analogicus/lelo_gr04_sky130a/rtl/README.md

The `osc_measure.pnl.v` file is automatically generated by the step "Fill Insertion" of LibreLane. It is the final post-synthesis netlist will all components added, as well as the power ports (`VPWR` and `VGND`). 

If you change the design, remember to also replace this file for LVS. Also, you can replace the `sta_post_pnr.html` and `lvs.netgen.rpt` reports from their respective steps. `sta_post_pnr.html` is captured and printed to html manually in the IPython notebook.
