analogicus/lelo_gr04_sky130a/sim/LELO_GR04/README.md

TB_NCM

#### Transient analysis (tran)

Check transient operation

|**Name**|**Parameter**|**Description**| |**Min**|**Typ**|**Max**| Unit|
|:---|:---|:---|---:|:---:|:---:|:---:| ---:|
|**Active current**|**idd\_-45** || **Spec**  | **10.000** | **40.000** | **70.000** | **uA** |
| | | |<a href='results/tran_Sch_typical.html'>Sch_typ</a>| | 14.550 |  | |
| | | |<a href='results/tran_Sch_etc_notemp.html'>Sch_etc_notemp</a>|<span style='color:red'>**9.061**</span> | 14.447 | 19.170 | |
| | | |<a href='results/tran_Sch_mc.html'>Sch_3std</a>|<span style='color:red'>**8.358**</span> | 14.952 | 21.546 | |
| | | |<a href='results/tran_Lay_typical.html'>Lay_typ</a>| | 14.579 |  | |
| | | |<a href='results/tran_Lay_etc_notemp.html'>Lay_etc_notemp</a>|<span style='color:red'>**8.260**</span> | 14.487 | 19.554 | |
| | | |<a href='results/tran_Lay_mc.html'>Lay_3std</a>|<span style='color:red'>**6.921**</span> | 14.355 | 21.789 | |
|**Active current**|**idd\_25** || **Spec**  | **10.000** | **40.000** | **70.000** | **uA** |
| | | |<a href='results/tran_Sch_typical.html'>Sch_typ</a>| | 23.083 |  | |
| | | |<a href='results/tran_Sch_etc_notemp.html'>Sch_etc_notemp</a>|17.652 | 23.163 | 30.716 | |
| | | |<a href='results/tran_Sch_mc.html'>Sch_3std</a>|17.553 | 23.322 | 29.092 | |
| | | |<a href='results/tran_Lay_typical.html'>Lay_typ</a>| | 23.460 |  | |
| | | |<a href='results/tran_Lay_etc_notemp.html'>Lay_etc_notemp</a>|17.834 | 23.538 | 31.436 | |
| | | |<a href='results/tran_Lay_mc.html'>Lay_3std</a>|16.698 | 23.255 | 29.812 | |
|**Active current**|**idd\_125** || **Spec**  | **10.000** | **40.000** | **70.000** | **uA** |
| | | |<a href='results/tran_Sch_typical.html'>Sch_typ</a>| | 36.946 |  | |
| | | |<a href='results/tran_Sch_etc_notemp.html'>Sch_etc_notemp</a>|29.076 | 37.016 | 47.541 | |
| | | |<a href='results/tran_Sch_mc.html'>Sch_3std</a>|31.487 | 37.137 | 42.787 | |
| | | |<a href='results/tran_Lay_typical.html'>Lay_typ</a>| | 37.853 |  | |
| | | |<a href='results/tran_Lay_etc_notemp.html'>Lay_etc_notemp</a>|29.602 | 37.909 | 49.014 | |
| | | |<a href='results/tran_Lay_mc.html'>Lay_3std</a>|31.108 | 37.686 | 44.264 | |
|**Leakage current**|**iddq\_-45** || **Spec**  | **0.000** | **50.000** | **100.000** | **nA** |
| | | |<a href='results/tran_Sch_typical.html'>Sch_typ</a>| | 1.314 |  | |
| | | |<a href='results/tran_Sch_etc_notemp.html'>Sch_etc_notemp</a>|0.855 | 1.150 | 1.456 | |
| | | |<a href='results/tran_Sch_mc.html'>Sch_3std</a>|0.800 | 1.197 | 1.594 | |
| | | |<a href='results/tran_Lay_typical.html'>Lay_typ</a>| | 1.743 |  | |
| | | |<a href='results/tran_Lay_etc_notemp.html'>Lay_etc_notemp</a>|1.859 | 2.622 | 2.808 | |
| | | |<a href='results/tran_Lay_mc.html'>Lay_3std</a>|1.464 | 2.490 | 3.516 | |
|**Leakage current**|**iddq\_25** || **Spec**  | **0.000** | **50.000** | **100.000** | **nA** |
| | | |<a href='results/tran_Sch_typical.html'>Sch_typ</a>| | 1.913 |  | |
| | | |<a href='results/tran_Sch_etc_notemp.html'>Sch_etc_notemp</a>|1.256 | 1.921 | 8.685 | |
| | | |<a href='results/tran_Sch_mc.html'>Sch_3std</a>|1.454 | 1.881 | 2.308 | |
| | | |<a href='results/tran_Lay_typical.html'>Lay_typ</a>| | 3.424 |  | |
| | | |<a href='results/tran_Lay_etc_notemp.html'>Lay_etc_notemp</a>|2.720 | 3.402 | 11.257 | |
| | | |<a href='results/tran_Lay_mc.html'>Lay_3std</a>|2.577 | 3.297 | 4.017 | |
|**Leakage current**|**iddq\_125** || **Spec**  | **0.000** | **50.000** | **100.000** | **nA** |
| | | |<a href='results/tran_Sch_typical.html'>Sch_typ</a>| | 10.349 |  | |
| | | |<a href='results/tran_Sch_etc_notemp.html'>Sch_etc_notemp</a>|9.787 | 15.645 | 39.508 | |
| | | |<a href='results/tran_Sch_mc.html'>Sch_3std</a>|10.124 | 10.457 | 10.790 | |
| | | |<a href='results/tran_Lay_typical.html'>Lay_typ</a>| | 15.454 |  | |
| | | |<a href='results/tran_Lay_etc_notemp.html'>Lay_etc_notemp</a>|12.109 | 20.570 | 44.940 | |
| | | |<a href='results/tran_Lay_mc.html'>Lay_3std</a>|14.511 | 15.328 | 16.145 | |
|**Oscillation frequency @ -45C**|**fosc\_-45** || **Spec**  | **1.406** | **1.875** | **2.344** | **MHz** |
| | | |<a href='results/tran_Sch_typical.html'>Sch_typ</a>| | 1.813 |  | |
| | | |<a href='results/tran_Sch_etc_notemp.html'>Sch_etc_notemp</a>|<span style='color:red'>**1.106**</span> | 1.797 | <span style='color:orange'>**2.448**</span> | |
| | | |<a href='results/tran_Sch_mc.html'>Sch_3std</a>|<span style='color:red'>**0.915**</span> | 1.844 | <span style='color:red'>**2.774**</span> | |
| | | |<a href='results/tran_Lay_typical.html'>Lay_typ</a>| | 1.470 |  | |
| | | |<a href='results/tran_Lay_etc_notemp.html'>Lay_etc_notemp</a>|<span style='color:red'>**0.850**</span> | 1.449 | 1.943 | |
| | | |<a href='results/tran_Lay_mc.html'>Lay_3std</a>|<span style='color:red'>**0.702**</span> | 1.440 | 2.179 | |
|**Oscillation frequency @ 25C**|**fosc\_25** || **Spec**  | **2.081** | **2.775** | **3.469** | **MHz** |
| | | |<a href='results/tran_Sch_typical.html'>Sch_typ</a>| | 2.696 |  | |
| | | |<a href='results/tran_Sch_etc_notemp.html'>Sch_etc_notemp</a>|<span style='color:orange'>**2.064**</span> | 2.699 | <span style='color:orange'>**3.644**</span> | |
| | | |<a href='results/tran_Sch_mc.html'>Sch_3std</a>|<span style='color:red'>**1.773**</span> | 2.711 | <span style='color:orange'>**3.650**</span> | |
| | | |<a href='results/tran_Lay_typical.html'>Lay_typ</a>| | 2.168 |  | |
| | | |<a href='results/tran_Lay_etc_notemp.html'>Lay_etc_notemp</a>|<span style='color:red'>**1.690**</span> | 2.170 | 2.852 | |
| | | |<a href='results/tran_Lay_mc.html'>Lay_3std</a>|<span style='color:red'>**1.427**</span> | 2.139 | 2.852 | |
|**Oscillation frequency @ 125C**|**fosc\_125** || **Spec**  | **3.598** | **4.797** | **5.996** | **MHz** |
| | | |<a href='results/tran_Sch_typical.html'>Sch_typ</a>| | 4.522 |  | |
| | | |<a href='results/tran_Sch_etc_notemp.html'>Sch_etc_notemp</a>|<span style='color:orange'>**3.470**</span> | 4.562 | <span style='color:orange'>**6.186**</span> | |
| | | |<a href='results/tran_Sch_mc.html'>Sch_3std</a>|<span style='color:red'>**3.392**</span> | 4.527 | 5.663 | |
| | | |<a href='results/tran_Lay_typical.html'>Lay_typ</a>| | <span style='color:orange'>**3.550**</span> |  | |
| | | |<a href='results/tran_Lay_etc_notemp.html'>Lay_etc_notemp</a>|<span style='color:red'>**2.788**</span> | <span style='color:orange'>**3.552**</span> | 4.648 | |
| | | |<a href='results/tran_Lay_mc.html'>Lay_3std</a>|<span style='color:red'>**2.616**</span> | <span style='color:orange'>**3.517**</span> | 4.418 | |
|**Temperature error (calibrated @ 25C)**|**t\_err\_max** || **Spec**  | **-10.00** | **0.00** | **10.00** | **C** |
| | | |<a href='results/tran_Sch_typical.html'>Sch_typ</a>| | 0.14 |  | |
| | | |<a href='results/tran_Sch_etc_notemp.html'>Sch_etc_notemp</a>|-1.83 | 0.08 | 3.61 | |
| | | |<a href='results/tran_Sch_mc.html'>Sch_3std</a>|<span style='color:red'>**-10.33**</span> | 5.08 | <span style='color:red'>**20.50**</span> | |
| | | |<a href='results/tran_Lay_typical.html'>Lay_typ</a>| | 0.17 |  | |
| | | |<a href='results/tran_Lay_etc_notemp.html'>Lay_etc_notemp</a>|-1.84 | 0.03 | 2.08 | |
| | | |<a href='results/tran_Lay_mc.html'>Lay_3std</a>|-9.18 | 3.39 | <span style='color:red'>**15.96**</span> | |
|**Temperature error (calibrated @ 25C)**|**t\_err\_min** || **Spec**  | **-10.00** | **0.00** | **10.00** | **C** |
| | | |<a href='results/tran_Sch_typical.html'>Sch_typ</a>| | -4.17 |  | |
| | | |<a href='results/tran_Sch_etc_notemp.html'>Sch_etc_notemp</a>|<span style='color:red'>**-62.49**</span> | -5.59 | -2.15 | |
| | | |<a href='results/tran_Sch_mc.html'>Sch_3std</a>|<span style='color:red'>**-24.64**</span> | <span style='color:red'>**-10.04**</span> | 4.57 | |
| | | |<a href='results/tran_Lay_typical.html'>Lay_typ</a>| | -6.51 |  | |
| | | |<a href='results/tran_Lay_etc_notemp.html'>Lay_etc_notemp</a>|<span style='color:red'>**-98.17**</span> | -8.15 | -4.02 | |
| | | |<a href='results/tran_Lay_mc.html'>Lay_3std</a>|<span style='color:red'>**-42.23**</span> | <span style='color:red'>**-13.59**</span> | <span style='color:red'>**15.05**</span> | |
|**Temperature error 0-70C (calibrated @ 25C)**|**t\_err\_com\_max** || **Spec**  | **-10.00** | **0.00** | **10.00** | **C** |
| | | |<a href='results/tran_Sch_typical.html'>Sch_typ</a>| | 0.14 |  | |
| | | |<a href='results/tran_Sch_etc_notemp.html'>Sch_etc_notemp</a>|-1.83 | 0.08 | 1.90 | |
| | | |<a href='results/tran_Sch_mc.html'>Sch_3std</a>|-3.51 | 2.08 | 7.67 | |
| | | |<a href='results/tran_Lay_typical.html'>Lay_typ</a>| | 0.17 |  | |
| | | |<a href='results/tran_Lay_etc_notemp.html'>Lay_etc_notemp</a>|-1.84 | 0.03 | 2.08 | |
| | | |<a href='results/tran_Lay_mc.html'>Lay_3std</a>|-5.27 | 1.81 | 8.90 | |
|**Temperature error 0-70C (calibrated @ 25C)**|**t\_err\_com\_min** || **Spec**  | **-10.00** | **0.00** | **10.00** | **C** |
| | | |<a href='results/tran_Sch_typical.html'>Sch_typ</a>| | -1.06 |  | |
| | | |<a href='results/tran_Sch_etc_notemp.html'>Sch_etc_notemp</a>|-5.09 | -1.16 | 0.72 | |
| | | |<a href='results/tran_Sch_mc.html'>Sch_3std</a>|-7.90 | -3.24 | 1.41 | |
| | | |<a href='results/tran_Lay_typical.html'>Lay_typ</a>| | -1.62 |  | |
| | | |<a href='results/tran_Lay_etc_notemp.html'>Lay_etc_notemp</a>|-8.85 | -1.81 | 0.40 | |
| | | |<a href='results/tran_Lay_mc.html'>Lay_3std</a>|<span style='color:red'>**-10.68**</span> | -3.53 | 3.61 | |
