analogicus/lelo_gr04_sky130a/sim/LELO_GR04_OSC_v2/README.md

TB_NCM

This testbench is deprecated in favor of the top-level `LELO_GR04` tests.

#### Transient analysis (tran)

Check transient operation

|**Name**|**Parameter**|**Description**| |**Min**|**Typ**|**Max**| Unit|
|:---|:---|:---|---:|:---:|:---:|:---:| ---:|
|**Active current**|**idd\_-45** || **Spec**  | **10.000** | **40.000** | **70.000** | **uA** |
| | | |<a href='results/tran_Sch_typical.html'>Sch_typ</a>| | 17.126 |  | |
| | | |<a href='results/tran_Sch_etc_notemp.html'>Sch_etc_notemp</a>|<span style='color:red'>**8.287**</span> | 16.891 | 22.358 | |
| | | |<a href='results/tran_Sch_mc.html'>Sch_3std</a>|<span style='color:red'>**8.979**</span> | 17.649 | 26.319 | |
| | | |<a href='results/tran_Lay_typical.html'>Lay_typ</a>| | 16.992 |  | |
| | | |<a href='results/tran_Lay_etc_notemp.html'>Lay_etc_notemp</a>|<span style='color:red'>**7.063**</span> | 16.693 | 22.694 | |
| | | |<a href='results/tran_Lay_mc.html'>Lay_3std</a>|<span style='color:red'>**5.799**</span> | 17.211 | 28.623 | |
|**Active current**|**idd\_125** || **Spec**  | **10.000** | **40.000** | **70.000** | **uA** |
| | | |<a href='results/tran_Sch_typical.html'>Sch_typ</a>| | 43.457 |  | |
| | | |<a href='results/tran_Sch_etc_notemp.html'>Sch_etc_notemp</a>|35.249 | 43.607 | 54.875 | |
| | | |<a href='results/tran_Sch_mc.html'>Sch_3std</a>|35.648 | 43.714 | 51.780 | |
| | | |<a href='results/tran_Lay_typical.html'>Lay_typ</a>| | 44.480 |  | |
| | | |<a href='results/tran_Lay_etc_notemp.html'>Lay_etc_notemp</a>|35.903 | 44.638 | 56.470 | |
| | | |<a href='results/tran_Lay_mc.html'>Lay_3std</a>|34.119 | 44.468 | 54.818 | |
|**Leakage current**|**iddq\_-45** || **Spec**  | **0.000** | **50.000** | **100.000** | **nA** |
| | | |<a href='results/tran_Sch_typical.html'>Sch_typ</a>| | 0.920 |  | |
| | | |<a href='results/tran_Sch_etc_notemp.html'>Sch_etc_notemp</a>|0.663 | 0.784 | 0.951 | |
| | | |<a href='results/tran_Sch_mc.html'>Sch_3std</a>|0.452 | 0.823 | 1.194 | |
| | | |<a href='results/tran_Lay_typical.html'>Lay_typ</a>| | 1.276 |  | |
| | | |<a href='results/tran_Lay_etc_notemp.html'>Lay_etc_notemp</a>|0.767 | 1.558 | 1.923 | |
| | | |<a href='results/tran_Lay_mc.html'>Lay_3std</a>|0.642 | 1.564 | 2.486 | |
|**Leakage current**|**iddq\_125** || **Spec**  | **0.000** | **50.000** | **100.000** | **nA** |
| | | |<a href='results/tran_Sch_typical.html'>Sch_typ</a>| | 7.084 |  | |
| | | |<a href='results/tran_Sch_etc_notemp.html'>Sch_etc_notemp</a>|6.275 | 12.102 | 34.271 | |
| | | |<a href='results/tran_Sch_mc.html'>Sch_3std</a>|7.003 | 7.229 | 7.455 | |
| | | |<a href='results/tran_Lay_typical.html'>Lay_typ</a>| | 10.187 |  | |
| | | |<a href='results/tran_Lay_etc_notemp.html'>Lay_etc_notemp</a>|8.696 | 15.362 | 38.049 | |
| | | |<a href='results/tran_Lay_mc.html'>Lay_3std</a>|9.793 | 10.385 | 10.977 | |
|**Oscillation frequency @ -45C**|**fosc\_-45** || **Spec**  | **1.406** | **1.875** | **2.344** | **MHz** |
| | | |<a href='results/tran_Sch_typical.html'>Sch_typ</a>| | 2.265 |  | |
| | | |<a href='results/tran_Sch_etc_notemp.html'>Sch_etc_notemp</a>|<span style='color:red'>**1.114**</span> | 2.208 | <span style='color:red'>**3.063**</span> | |
| | | |<a href='results/tran_Sch_mc.html'>Sch_3std</a>|<span style='color:red'>**1.038**</span> | 2.306 | <span style='color:red'>**3.575**</span> | |
| | | |<a href='results/tran_Lay_typical.html'>Lay_typ</a>| | 1.854 |  | |
| | | |<a href='results/tran_Lay_etc_notemp.html'>Lay_etc_notemp</a>|<span style='color:red'>**0.787**</span> | 1.790 | <span style='color:orange'>**2.462**</span> | |
| | | |<a href='results/tran_Lay_mc.html'>Lay_3std</a>|<span style='color:red'>**0.681**</span> | 1.878 | <span style='color:red'>**3.075**</span> | |
|**Oscillation frequency @ 25C**|**fosc\_25** || **Spec**  | **2.081** | **2.775** | **3.469** | **MHz** |
| | | |<a href='results/tran_Sch_typical.html'>Sch_typ</a>| | <span style='color:orange'>**3.472**</span> |  | |
| | | |<a href='results/tran_Sch_etc_notemp.html'>Sch_etc_notemp</a>|2.647 | 3.463 | <span style='color:red'>**4.745**</span> | |
| | | |<a href='results/tran_Sch_mc.html'>Sch_3std</a>|2.158 | <span style='color:orange'>**3.489**</span> | <span style='color:red'>**4.819**</span> | |
| | | |<a href='results/tran_Lay_typical.html'>Lay_typ</a>| | 2.823 |  | |
| | | |<a href='results/tran_Lay_etc_notemp.html'>Lay_etc_notemp</a>|2.194 | 2.817 | <span style='color:red'>**3.760**</span> | |
| | | |<a href='results/tran_Lay_mc.html'>Lay_3std</a>|<span style='color:red'>**1.660**</span> | 2.837 | <span style='color:red'>**4.014**</span> | |
|**Oscillation frequency @ 125C**|**fosc\_125** || **Spec**  | **3.598** | **4.797** | **5.996** | **MHz** |
| | | |<a href='results/tran_Sch_typical.html'>Sch_typ</a>| | 5.951 |  | |
| | | |<a href='results/tran_Sch_etc_notemp.html'>Sch_etc_notemp</a>|4.561 | <span style='color:orange'>**6.020**</span> | <span style='color:red'>**8.180**</span> | |
| | | |<a href='results/tran_Sch_mc.html'>Sch_3std</a>|4.284 | 5.956 | <span style='color:red'>**7.628**</span> | |
| | | |<a href='results/tran_Lay_typical.html'>Lay_typ</a>| | 4.715 |  | |
| | | |<a href='results/tran_Lay_etc_notemp.html'>Lay_etc_notemp</a>|3.691 | 4.717 | <span style='color:orange'>**6.232**</span> | |
| | | |<a href='results/tran_Lay_mc.html'>Lay_3std</a>|<span style='color:red'>**3.224**</span> | 4.710 | <span style='color:orange'>**6.197**</span> | |
|**Temperature error (calibrated @ 25C)**|**t\_err\_max** || **Spec**  | **-10.00** | **0.00** | **10.00** | **C** |
| | | |<a href='results/tran_Sch_typical.html'>Sch_typ</a>| | 0.14 |  | |
| | | |<a href='results/tran_Sch_etc_notemp.html'>Sch_etc_notemp</a>|-2.63 | 1.71 | 4.82 | |
| | | |<a href='results/tran_Sch_mc.html'>Sch_3std</a>|<span style='color:red'>**-10.15**</span> | 5.10 | <span style='color:red'>**20.34**</span> | |
| | | |<a href='results/tran_Lay_typical.html'>Lay_typ</a>| | 0.27 |  | |
| | | |<a href='results/tran_Lay_etc_notemp.html'>Lay_etc_notemp</a>|-2.27 | 0.24 | 4.85 | |
| | | |<a href='results/tran_Lay_mc.html'>Lay_3std</a>|<span style='color:red'>**-12.95**</span> | 4.36 | <span style='color:red'>**21.67**</span> | |
|**Temperature error (calibrated @ 25C)**|**t\_err\_min** || **Spec**  | **-10.00** | **0.00** | **10.00** | **C** |
| | | |<a href='results/tran_Sch_typical.html'>Sch_typ</a>| | -4.52 |  | |
| | | |<a href='results/tran_Sch_etc_notemp.html'>Sch_etc_notemp</a>|<span style='color:red'>**-92.04**</span> | -7.82 | -3.33 | |
| | | |<a href='results/tran_Sch_mc.html'>Sch_3std</a>|<span style='color:red'>**-24.96**</span> | <span style='color:red'>**-10.20**</span> | 4.56 | |
| | | |<a href='results/tran_Lay_typical.html'>Lay_typ</a>| | -7.28 |  | |
| | | |<a href='results/tran_Lay_etc_notemp.html'>Lay_etc_notemp</a>|<span style='color:red'>**-125.93**</span> | <span style='color:red'>**-11.09**</span> | -5.43 | |
| | | |<a href='results/tran_Lay_mc.html'>Lay_3std</a>|<span style='color:red'>**-38.32**</span> | <span style='color:red'>**-14.81**</span> | 8.71 | |
