analogicus/lelo_gr04_sky130a/sim/LELO_GR04/results/tran_Lay_etc_notemp.md

### Summary tran_Lay_etc_notemp

For details see <a href='tran_Lay_etc_notemp.html'>tran_Lay_etc_notemp.html</a>

|**Name**|**Parameter**|**View**|**Min** | **Typ** | **Max**|
|:---|:---|:---:|:---:|:---:|:---:|
|Active current|idd\_-45 | Spec | 10.000 uA | 40.000 uA | 70.000 uA |
| | | ('Lay',)|8.260 uA | 14.487 uA | 19.554 uA |
|Active current|idd\_25 | Spec | 10.000 uA | 40.000 uA | 70.000 uA |
| | | ('Lay',)|17.834 uA | 23.538 uA | 31.436 uA |
|Active current|idd\_125 | Spec | 10.000 uA | 40.000 uA | 70.000 uA |
| | | ('Lay',)|29.602 uA | 37.909 uA | 49.014 uA |
|Leakage current|iddq\_-45 | Spec | 0.000 nA | 50.000 nA | 100.000 nA |
| | | ('Lay',)|1.859 nA | 2.622 nA | 2.808 nA |
|Leakage current|iddq\_25 | Spec | 0.000 nA | 50.000 nA | 100.000 nA |
| | | ('Lay',)|2.720 nA | 3.402 nA | 11.257 nA |
|Leakage current|iddq\_125 | Spec | 0.000 nA | 50.000 nA | 100.000 nA |
| | | ('Lay',)|12.109 nA | 20.570 nA | 44.940 nA |
|Oscillation frequency @ -45C|fosc\_-45 | Spec | 1.406 MHz | 1.875 MHz | 2.344 MHz |
| | | ('Lay',)|0.850 MHz | 1.449 MHz | 1.943 MHz |
|Oscillation frequency @ 25C|fosc\_25 | Spec | 2.081 MHz | 2.775 MHz | 3.469 MHz |
| | | ('Lay',)|1.690 MHz | 2.170 MHz | 2.852 MHz |
|Oscillation frequency @ 125C|fosc\_125 | Spec | 3.598 MHz | 4.797 MHz | 5.996 MHz |
| | | ('Lay',)|2.788 MHz | 3.552 MHz | 4.648 MHz |
|Temperature error (calibrated @ 25C)|t\_err\_max | Spec | -10.00 C |  | 10.00 C |
| | | ('Lay',)|-1.84 C | 0.03 C | 2.08 C |
|Temperature error (calibrated @ 25C)|t\_err\_min | Spec | -10.00 C |  | 10.00 C |
| | | ('Lay',)|-98.17 C | -8.15 C | -4.02 C |
|Temperature error 0-70C (calibrated @ 25C)|t\_err\_com\_max | Spec | -10.00 C |  | 10.00 C |
| | | ('Lay',)|-1.84 C | 0.03 C | 2.08 C |
|Temperature error 0-70C (calibrated @ 25C)|t\_err\_com\_min | Spec | -10.00 C |  | 10.00 C |
| | | ('Lay',)|-8.85 C | -1.81 C | 0.40 C |
