analogicus/lelo_gr04_sky130a/sim/LELO_GR04/results/tran_Lay_mc.md

### Summary tran_Lay_mc

For details see <a href='tran_Lay_mc.html'>tran_Lay_mc.html</a>

|**Name**|**Parameter**|**View**|**Min** | **Typ** | **Max**|
|:---|:---|:---:|:---:|:---:|:---:|
|Active current|idd\_-45 | Spec | 10.000 uA | 40.000 uA | 70.000 uA |
| | | ('Lay',)|9.104 uA | 14.499 uA | 18.417 uA |
|Active current|idd\_25 | Spec | 10.000 uA | 40.000 uA | 70.000 uA |
| | | ('Lay',)|18.489 uA | 23.293 uA | 27.079 uA |
|Active current|idd\_125 | Spec | 10.000 uA | 40.000 uA | 70.000 uA |
| | | ('Lay',)|33.102 uA | 37.829 uA | 41.557 uA |
|Leakage current|iddq\_-45 | Spec | 0.000 nA | 50.000 nA | 100.000 nA |
| | | ('Lay',)|1.629 nA | 2.720 nA | 2.786 nA |
|Leakage current|iddq\_25 | Spec | 0.000 nA | 50.000 nA | 100.000 nA |
| | | ('Lay',)|2.442 nA | 3.423 nA | 3.530 nA |
|Leakage current|iddq\_125 | Spec | 0.000 nA | 50.000 nA | 100.000 nA |
| | | ('Lay',)|14.778 nA | 15.414 nA | 15.746 nA |
|Oscillation frequency @ -45C|fosc\_-45 | Spec | 1.406 MHz | 1.875 MHz | 2.344 MHz |
| | | ('Lay',)|0.955 MHz | 1.468 MHz | 1.897 MHz |
|Oscillation frequency @ 25C|fosc\_25 | Spec | 2.081 MHz | 2.775 MHz | 3.469 MHz |
| | | ('Lay',)|1.641 MHz | 2.140 MHz | 2.576 MHz |
|Oscillation frequency @ 125C|fosc\_125 | Spec | 3.598 MHz | 4.797 MHz | 5.996 MHz |
| | | ('Lay',)|2.919 MHz | 3.556 MHz | 4.000 MHz |
|Temperature error (calibrated @ 25C)|t\_err\_max | Spec | -10.00 C |  | 10.00 C |
| | | ('Lay',)| | 1.22 C | 13.48 C |
|Temperature error (calibrated @ 25C)|t\_err\_min | Spec | -10.00 C |  | 10.00 C |
| | | ('Lay',)|-35.52 C | -10.94 C | -2.82 C |
|Temperature error 0-70C (calibrated @ 25C)|t\_err\_com\_max | Spec | -10.00 C |  | 10.00 C |
| | | ('Lay',)| | 0.92 C | 8.42 C |
|Temperature error 0-70C (calibrated @ 25C)|t\_err\_com\_min | Spec | -10.00 C |  | 10.00 C |
| | | ('Lay',)|-9.92 C | -2.28 C | -1.15 C |
