analogicus/lelo_gr04_sky130a/sim/LELO_GR04/results/tran_Sch_etc_notemp.md

### Summary tran_Sch_etc_notemp

For details see <a href='tran_Sch_etc_notemp.html'>tran_Sch_etc_notemp.html</a>

|**Name**|**Parameter**|**View**|**Min** | **Typ** | **Max**|
|:---|:---|:---:|:---:|:---:|:---:|
|Active current|idd\_-45 | Spec | 10.000 uA | 40.000 uA | 70.000 uA |
| | | ('Sch',)|9.061 uA | 14.447 uA | 19.170 uA |
|Active current|idd\_25 | Spec | 10.000 uA | 40.000 uA | 70.000 uA |
| | | ('Sch',)|17.652 uA | 23.163 uA | 30.716 uA |
|Active current|idd\_125 | Spec | 10.000 uA | 40.000 uA | 70.000 uA |
| | | ('Sch',)|29.076 uA | 37.016 uA | 47.541 uA |
|Leakage current|iddq\_-45 | Spec | 0.000 nA | 50.000 nA | 100.000 nA |
| | | ('Sch',)|0.855 nA | 1.150 nA | 1.456 nA |
|Leakage current|iddq\_25 | Spec | 0.000 nA | 50.000 nA | 100.000 nA |
| | | ('Sch',)|1.256 nA | 1.921 nA | 8.685 nA |
|Leakage current|iddq\_125 | Spec | 0.000 nA | 50.000 nA | 100.000 nA |
| | | ('Sch',)|9.787 nA | 15.645 nA | 39.508 nA |
|Oscillation frequency @ -45C|fosc\_-45 | Spec | 1.406 MHz | 1.875 MHz | 2.344 MHz |
| | | ('Sch',)|1.106 MHz | 1.797 MHz | 2.448 MHz |
|Oscillation frequency @ 25C|fosc\_25 | Spec | 2.081 MHz | 2.775 MHz | 3.469 MHz |
| | | ('Sch',)|2.064 MHz | 2.699 MHz | 3.644 MHz |
|Oscillation frequency @ 125C|fosc\_125 | Spec | 3.598 MHz | 4.797 MHz | 5.996 MHz |
| | | ('Sch',)|3.470 MHz | 4.562 MHz | 6.186 MHz |
|Temperature error (calibrated @ 25C)|t\_err\_max | Spec | -10.00 C |  | 10.00 C |
| | | ('Sch',)|-1.83 C | 0.08 C | 3.61 C |
|Temperature error (calibrated @ 25C)|t\_err\_min | Spec | -10.00 C |  | 10.00 C |
| | | ('Sch',)|-62.49 C | -5.59 C | -2.15 C |
|Temperature error 0-70C (calibrated @ 25C)|t\_err\_com\_max | Spec | -10.00 C |  | 10.00 C |
| | | ('Sch',)|-1.83 C | 0.08 C | 1.90 C |
|Temperature error 0-70C (calibrated @ 25C)|t\_err\_com\_min | Spec | -10.00 C |  | 10.00 C |
| | | ('Sch',)|-5.09 C | -1.16 C | 0.72 C |
