analogicus/lelo_gr04_sky130a/sim/LELO_GR04_BG/results/dc_Lay_etc.md

### Summary dc_Lay_etc

For details see <a href='dc_Lay_etc.html'>dc_Lay_etc.html</a>

|**Name**|**Parameter**|**View**|**Min** | **Typ** | **Max**|
|:---|:---|:---:|:---:|:---:|:---:|
|IPTAT @ 0.5V output & 25C|i1\_25 | Spec | 1.100 uA | 1.700 uA | 2.300 uA |
| | | ('Lay',)|1.938 uA | 2.221 uA | 2.615 uA |
|IPTAT temperature coefficient @ 0.5V output|a1 | Spec | 2.500 nA / K | 5.000 nA / K | 7.500 nA / K |
| | | ('Lay',)|6.515 nA / K | 7.422 nA / K | 8.577 nA / K |
|IPTAT temperature coefficient (avg)|a\_avg | Spec | 2.500 nA / K | 5.000 nA / K | 7.500 nA / K |
| | | ('Lay',)|6.505 nA / K | 7.405 nA / K | 8.552 nA / K |
|VCTAT @ 25C|v\_ctat\_25 | Spec | 650.000 mV | 700.000 mV | 750.000 mV |
| | | ('Lay',)|705.853 mV | 707.002 mV | 708.227 mV |
|VCTAT temperature coefficient|a\_ctat | Spec | -2.000 mV / K | -1.800 mV / K | -1.600 mV / K |
| | | ('Lay',)|-1.808 mV / K | -1.794 mV / K | -1.781 mV / K |
|IPTAT error @ 0.5V output|i1\_err\_max | Spec | -30.000 nA |  | 30.000 nA |
| | | ('Lay',)|4.222 nA | 7.735 nA | 43.486 nA |
|IPTAT error @ 0.5V output|i1\_err\_min | Spec | -30.000 nA |  | 30.000 nA |
| | | ('Lay',)|-108.631 nA | -35.679 nA | -23.780 nA |
|IPTAT error @ 0.8V output|i2\_err\_max | Spec | -30.000 nA |  | 30.000 nA |
| | | ('Lay',)|4.226 nA | 7.741 nA | 43.455 nA |
|IPTAT error @ 0.8V output|i2\_err\_min | Spec | -30.000 nA |  | 30.000 nA |
| | | ('Lay',)|-108.654 nA | -35.704 nA | -23.798 nA |
|VCTAT error|v\_ctat\_err\_max | Spec | -9.000 mV |  | 9.000 mV |
| | | ('Lay',)| | 0.203 mV | 0.260 mV |
|VCTAT error|v\_ctat\_err\_min | Spec | -9.000 mV |  | 9.000 mV |
| | | ('Lay',)|-6.638 mV | -4.562 mV | -4.193 mV |
