analogicus/lelo_gr04_sky130a/sim/LELO_GR04_BG/results/dc_Lay_mc.md

### Summary dc_Lay_mc

For details see <a href='dc_Lay_mc.html'>dc_Lay_mc.html</a>

|**Name**|**Parameter**|**View**|**Min** | **Typ** | **Max**|
|:---|:---|:---:|:---:|:---:|:---:|
|IPTAT @ 0.5V output & 25C|i1\_25 | Spec | 1.100 uA | 1.700 uA | 2.300 uA |
| | | ('Lay',)|1.558 uA | 2.215 uA | 3.136 uA |
|IPTAT temperature coefficient @ 0.5V output|a1 | Spec | 2.500 nA / K | 5.000 nA / K | 7.500 nA / K |
| | | ('Lay',)|4.562 nA / K | 7.369 nA / K | 8.424 nA / K |
|IPTAT temperature coefficient (avg)|a\_avg | Spec | 2.500 nA / K | 5.000 nA / K | 7.500 nA / K |
| | | ('Lay',)|4.639 nA / K | 7.418 nA / K | 8.435 nA / K |
|VCTAT @ 25C|v\_ctat\_25 | Spec | 650.000 mV | 700.000 mV | 750.000 mV |
| | | ('Lay',)|688.906 mV | 706.684 mV | 726.819 mV |
|VCTAT temperature coefficient|a\_ctat | Spec | -2.000 mV / K | -1.800 mV / K | -1.600 mV / K |
| | | ('Lay',)|-1.861 mV / K | -1.796 mV / K | -1.754 mV / K |
|IPTAT error @ 0.5V output|i1\_err\_max | Spec | -30.000 nA |  | 30.000 nA |
| | | ('Lay',)|0.001 nA | 5.815 nA | 196.617 nA |
|IPTAT error @ 0.5V output|i1\_err\_min | Spec | -30.000 nA |  | 30.000 nA |
| | | ('Lay',)|-122.542 nA | -31.573 nA | -9.106 nA |
|IPTAT error @ 0.8V output|i2\_err\_max | Spec | -30.000 nA |  | 30.000 nA |
| | | ('Lay',)| | 5.837 nA | 194.359 nA |
|IPTAT error @ 0.8V output|i2\_err\_min | Spec | -30.000 nA |  | 30.000 nA |
| | | ('Lay',)|-120.000 nA | -33.303 nA | -8.691 nA |
|VCTAT error|v\_ctat\_err\_max | Spec | -9.000 mV |  | 9.000 mV |
| | | ('Lay',)|0.004 mV | 0.205 mV | 2.133 mV |
|VCTAT error|v\_ctat\_err\_min | Spec | -9.000 mV |  | 9.000 mV |
| | | ('Lay',)|-7.707 mV | -4.684 mV | -1.532 mV |
