analogicus/lelo_gr04_sky130a/sim/LELO_GR04_BG/results/dc_Sch_etc.md

### Summary dc_Sch_etc

For details see <a href='dc_Sch_etc.html'>dc_Sch_etc.html</a>

|**Name**|**Parameter**|**View**|**Min** | **Typ** | **Max**|
|:---|:---|:---:|:---:|:---:|:---:|
|IPTAT @ 0.5V output & 25C|i1\_25 | Spec | 1.100 uA | 1.700 uA | 2.300 uA |
| | | ('Sch',)|1.938 uA | 2.221 uA | 2.615 uA |
|IPTAT temperature coefficient @ 0.5V output|a1 | Spec | 2.500 nA / K | 5.000 nA / K | 7.500 nA / K |
| | | ('Sch',)|6.515 nA / K | 7.422 nA / K | 8.577 nA / K |
|IPTAT temperature coefficient (avg)|a\_avg | Spec | 2.500 nA / K | 5.000 nA / K | 7.500 nA / K |
| | | ('Sch',)|6.505 nA / K | 7.405 nA / K | 8.552 nA / K |
|VCTAT @ 25C|v\_ctat\_25 | Spec | 650.000 mV | 700.000 mV | 750.000 mV |
| | | ('Sch',)|705.853 mV | 707.002 mV | 708.227 mV |
|VCTAT temperature coefficient|a\_ctat | Spec | -2.000 mV / K | -1.800 mV / K | -1.600 mV / K |
| | | ('Sch',)|-1.808 mV / K | -1.796 mV / K | -1.781 mV / K |
|IPTAT error @ 0.5V output|i1\_err\_max | Spec | -30.000 nA |  | 30.000 nA |
| | | ('Sch',)|4.222 nA | 7.733 nA | 24.897 nA |
|IPTAT error @ 0.5V output|i1\_err\_min | Spec | -30.000 nA |  | 30.000 nA |
| | | ('Sch',)|-64.695 nA | -34.315 nA | -23.783 nA |
|IPTAT error @ 0.8V output|i2\_err\_max | Spec | -30.000 nA |  | 30.000 nA |
| | | ('Sch',)|4.227 nA | 7.739 nA | 24.864 nA |
|IPTAT error @ 0.8V output|i2\_err\_min | Spec | -30.000 nA |  | 30.000 nA |
| | | ('Sch',)|-64.722 nA | -34.350 nA | -23.801 nA |
|VCTAT error|v\_ctat\_err\_max | Spec | -9.000 mV |  | 9.000 mV |
| | | ('Sch',)|0.074 mV | 0.227 mV | 0.283 mV |
|VCTAT error|v\_ctat\_err\_min | Spec | -9.000 mV |  | 9.000 mV |
| | | ('Sch',)|-5.385 mV | -4.542 mV | -4.196 mV |
