analogicus/lelo_gr04_sky130a/sim/LELO_GR04_BG/results/dc_Sch_mc.md

### Summary dc_Sch_mc

For details see <a href='dc_Sch_mc.html'>dc_Sch_mc.html</a>

|**Name**|**Parameter**|**View**|**Min** | **Typ** | **Max**|
|:---|:---|:---:|:---:|:---:|:---:|
|IPTAT @ 0.5V output & 25C|i1\_25 | Spec | 1.100 uA | 1.700 uA | 2.300 uA |
| | | ('Sch',)|1.650 uA | 2.211 uA | 2.875 uA |
|IPTAT temperature coefficient @ 0.5V output|a1 | Spec | 2.500 nA / K | 5.000 nA / K | 7.500 nA / K |
| | | ('Sch',)|5.295 nA / K | 7.161 nA / K | 8.088 nA / K |
|IPTAT temperature coefficient (avg)|a\_avg | Spec | 2.500 nA / K | 5.000 nA / K | 7.500 nA / K |
| | | ('Sch',)|5.237 nA / K | 7.168 nA / K | 8.044 nA / K |
|VCTAT @ 25C|v\_ctat\_25 | Spec | 650.000 mV | 700.000 mV | 750.000 mV |
| | | ('Sch',)|692.521 mV | 708.753 mV | 723.121 mV |
|VCTAT temperature coefficient|a\_ctat | Spec | -2.000 mV / K | -1.800 mV / K | -1.600 mV / K |
| | | ('Sch',)|-1.858 mV / K | -1.802 mV / K | -1.775 mV / K |
|IPTAT error @ 0.5V output|i1\_err\_max | Spec | -30.000 nA |  | 30.000 nA |
| | | ('Sch',)|0.064 nA | 7.735 nA | 119.956 nA |
|IPTAT error @ 0.5V output|i1\_err\_min | Spec | -30.000 nA |  | 30.000 nA |
| | | ('Sch',)|-106.704 nA | -26.190 nA | -13.700 nA |
|IPTAT error @ 0.8V output|i2\_err\_max | Spec | -30.000 nA |  | 30.000 nA |
| | | ('Sch',)| | 7.753 nA | 131.015 nA |
|IPTAT error @ 0.8V output|i2\_err\_min | Spec | -30.000 nA |  | 30.000 nA |
| | | ('Sch',)|-101.536 nA | -24.648 nA | -15.355 nA |
|VCTAT error|v\_ctat\_err\_max | Spec | -9.000 mV |  | 9.000 mV |
| | | ('Sch',)|0.027 mV | 0.243 mV | 1.514 mV |
|VCTAT error|v\_ctat\_err\_min | Spec | -9.000 mV |  | 9.000 mV |
| | | ('Sch',)|-7.086 mV | -4.342 mV | -1.422 mV |
