analogicus/lelo_gr04_sky130a/sim/LELO_GR04_BG/results/dc_Sch_typical.md

### Summary dc_Sch_typical

For details see <a href='dc_Sch_typical.html'>dc_Sch_typical.html</a>

|**Name**|**Parameter**|**View**|**Min** | **Typ** | **Max**|
|:---|:---|:---:|:---:|:---:|:---:|
|IPTAT @ 0.5V output & 25C|i1\_25 | Spec | 1.100 uA | 1.700 uA | 2.300 uA |
| | | ('Sch',)|2.228 uA | 2.228 uA | 2.228 uA |
|IPTAT temperature coefficient @ 0.5V output|a1 | Spec | 2.500 nA / K | 5.000 nA / K | 7.500 nA / K |
| | | ('Sch',)|7.331 nA / K | 7.331 nA / K | 7.331 nA / K |
|IPTAT temperature coefficient (avg)|a\_avg | Spec | 2.500 nA / K | 5.000 nA / K | 7.500 nA / K |
| | | ('Sch',)|7.308 nA / K | 7.308 nA / K | 7.308 nA / K |
|VCTAT @ 25C|v\_ctat\_25 | Spec | 650.000 mV | 700.000 mV | 750.000 mV |
| | | ('Sch',)|707.004 mV | 707.004 mV | 707.004 mV |
|VCTAT temperature coefficient|a\_ctat | Spec | -2.000 mV / K | -1.800 mV / K | -1.600 mV / K |
| | | ('Sch',)|-1.799 mV / K | -1.799 mV / K | -1.799 mV / K |
|IPTAT error @ 0.5V output|i1\_err\_max | Spec | -30.000 nA |  | 30.000 nA |
| | | ('Sch',)|8.079 nA | 8.079 nA | 8.079 nA |
|IPTAT error @ 0.5V output|i1\_err\_min | Spec | -30.000 nA |  | 30.000 nA |
| | | ('Sch',)|-30.769 nA | -30.769 nA | -30.769 nA |
|IPTAT error @ 0.8V output|i2\_err\_max | Spec | -30.000 nA |  | 30.000 nA |
| | | ('Sch',)|8.083 nA | 8.083 nA | 8.083 nA |
|IPTAT error @ 0.8V output|i2\_err\_min | Spec | -30.000 nA |  | 30.000 nA |
| | | ('Sch',)|-30.792 nA | -30.792 nA | -30.792 nA |
|VCTAT error|v\_ctat\_err\_max | Spec | -9.000 mV |  | 9.000 mV |
| | | ('Sch',)|0.243 mV | 0.243 mV | 0.243 mV |
|VCTAT error|v\_ctat\_err\_min | Spec | -9.000 mV |  | 9.000 mV |
| | | ('Sch',)|-4.407 mV | -4.407 mV | -4.407 mV |
