analogicus/lelo_gr04_sky130a/sim/LELO_GR04_BG/results/tran_Lay_etc.md

### Summary tran_Lay_etc

For details see <a href='tran_Lay_etc.html'>tran_Lay_etc.html</a>

|**Name**|**Parameter**|**View**|**Min** | **Typ** | **Max**|
|:---|:---|:---:|:---:|:---:|:---:|
|Active current|idd | Spec | 5.000 uA | 15.000 uA | 50.000 uA |
| | | ('Lay',)|8.496 uA | 17.687 uA | 35.170 uA |
|Leakage current|iddq | Spec | 0.000 nA | 0.500 nA | 1.000 nA |
| | | ('Lay',)|0.720 nA | 3.123 nA | 13.024 nA |
|Output current @ 0.2-1.1V|i0 | Spec | 1.000 uA | 1.700 uA | 2.600 uA |
| | | ('Lay',)|1.520 uA | 2.337 uA | 3.463 uA |
|Output current @ 0.2-1.1V|i1 | Spec | 1.000 uA | 1.700 uA | 2.600 uA |
| | | ('Lay',)|1.520 uA | 2.337 uA | 3.463 uA |
|Output current @ 0.2-1.1V|i2 | Spec | 1.000 uA | 1.700 uA | 2.600 uA |
| | | ('Lay',)|1.520 uA | 2.337 uA | 3.463 uA |
|Output current @ 0.2-1.1V|i3 | Spec | 1.000 uA | 1.700 uA | 2.600 uA |
| | | ('Lay',)|1.520 uA | 2.335 uA | 3.448 uA |
|Bandgap resistor voltage|vrd | Spec | 30.000 mV | 52.000 mV | 80.000 mV |
| | | ('Lay',)|40.473 mV | 57.774 mV | 75.444 mV |
|Settling time (2%) @ 0.5V|t\_settle\_98 | Spec | 0.000 us | 1.000 us | 5.000 us |
| | | ('Lay',)|0.068 us | 0.106 us | 7.914 us |
