analogicus/lelo_gr04_sky130a/sim/LELO_GR04_BG/results/tran_Lay_mc.md

### Summary tran_Lay_mc

For details see <a href='tran_Lay_mc.html'>tran_Lay_mc.html</a>

|**Name**|**Parameter**|**View**|**Min** | **Typ** | **Max**|
|:---|:---|:---:|:---:|:---:|:---:|
|Active current|idd | Spec | 5.000 uA | 15.000 uA | 50.000 uA |
| | | ('Lay',)|14.369 uA | 17.113 uA | 21.298 uA |
|Leakage current|iddq | Spec | 0.000 nA | 0.500 nA | 1.000 nA |
| | | ('Lay',)|2.304 nA | 2.323 nA | 2.335 nA |
|Output current @ 0.2-1.1V|i0 | Spec | 1.000 uA | 1.700 uA | 2.600 uA |
| | | ('Lay',)|1.731 uA | 2.252 uA | 3.019 uA |
|Output current @ 0.2-1.1V|i1 | Spec | 1.000 uA | 1.700 uA | 2.600 uA |
| | | ('Lay',)|1.618 uA | 2.266 uA | 3.182 uA |
|Output current @ 0.2-1.1V|i2 | Spec | 1.000 uA | 1.700 uA | 2.600 uA |
| | | ('Lay',)|1.665 uA | 2.259 uA | 3.185 uA |
|Output current @ 0.2-1.1V|i3 | Spec | 1.000 uA | 1.700 uA | 2.600 uA |
| | | ('Lay',)|1.744 uA | 2.266 uA | 3.157 uA |
|Bandgap resistor voltage|vrd | Spec | 30.000 mV | 52.000 mV | 80.000 mV |
| | | ('Lay',)|43.296 mV | 54.589 mV | 68.692 mV |
|Settling time (2%) @ 0.5V|t\_settle\_98 | Spec | 0.000 us | 1.000 us | 5.000 us |
| | | ('Lay',)|0.096 us | 0.106 us | 0.119 us |
