analogicus/lelo_gr04_sky130a/sim/LELO_GR04_BG/results/tran_Lay_typical.md

### Summary tran_Lay_typical

For details see <a href='tran_Lay_typical.html'>tran_Lay_typical.html</a>

|**Name**|**Parameter**|**View**|**Min** | **Typ** | **Max**|
|:---|:---|:---:|:---:|:---:|:---:|
|Active current|idd | Spec | 5.000 uA | 15.000 uA | 50.000 uA |
| | | ('Lay',)|17.164 uA | 17.164 uA | 17.164 uA |
|Leakage current|iddq | Spec | 0.000 nA | 0.500 nA | 1.000 nA |
| | | ('Lay',)|2.321 nA | 2.321 nA | 2.321 nA |
|Output current @ 0.2-1.1V|i0 | Spec | 1.000 uA | 1.700 uA | 2.600 uA |
| | | ('Lay',)|2.282 uA | 2.282 uA | 2.282 uA |
|Output current @ 0.2-1.1V|i1 | Spec | 1.000 uA | 1.700 uA | 2.600 uA |
| | | ('Lay',)|2.282 uA | 2.282 uA | 2.282 uA |
|Output current @ 0.2-1.1V|i2 | Spec | 1.000 uA | 1.700 uA | 2.600 uA |
| | | ('Lay',)|2.282 uA | 2.282 uA | 2.282 uA |
|Output current @ 0.2-1.1V|i3 | Spec | 1.000 uA | 1.700 uA | 2.600 uA |
| | | ('Lay',)|2.281 uA | 2.281 uA | 2.281 uA |
|Bandgap resistor voltage|vrd | Spec | 30.000 mV | 52.000 mV | 80.000 mV |
| | | ('Lay',)|54.843 mV | 54.843 mV | 54.843 mV |
|Settling time (2%) @ 0.5V|t\_settle\_98 | Spec | 0.000 us | 1.000 us | 5.000 us |
| | | ('Lay',)|0.106 us | 0.106 us | 0.106 us |
