analogicus/lelo_gr04_sky130a/sim/LELO_GR04_BG/results/tran_Sch_etc.md

### Summary tran_Sch_etc

For details see <a href='tran_Sch_etc.html'>tran_Sch_etc.html</a>

|**Name**|**Parameter**|**View**|**Min** | **Typ** | **Max**|
|:---|:---|:---:|:---:|:---:|:---:|
|Active current|idd | Spec | 5.000 uA | 15.000 uA | 50.000 uA |
| | | ('Sch',)|7.954 uA | 17.419 uA | 35.457 uA |
|Leakage current|iddq | Spec | 0.000 nA | 0.500 nA | 1.000 nA |
| | | ('Sch',)|0.526 nA | 2.511 nA | 13.787 nA |
|Output current @ 0.2-1.1V|i0 | Spec | 1.000 uA | 1.700 uA | 2.600 uA |
| | | ('Sch',)|1.520 uA | 2.337 uA | 3.463 uA |
|Output current @ 0.2-1.1V|i1 | Spec | 1.000 uA | 1.700 uA | 2.600 uA |
| | | ('Sch',)|1.520 uA | 2.337 uA | 3.463 uA |
|Output current @ 0.2-1.1V|i2 | Spec | 1.000 uA | 1.700 uA | 2.600 uA |
| | | ('Sch',)|1.520 uA | 2.337 uA | 3.463 uA |
|Output current @ 0.2-1.1V|i3 | Spec | 1.000 uA | 1.700 uA | 2.600 uA |
| | | ('Sch',)|1.520 uA | 2.335 uA | 3.448 uA |
|Bandgap resistor voltage|vrd | Spec | 30.000 mV | 52.000 mV | 80.000 mV |
| | | ('Sch',)|41.248 mV | 57.774 mV | 75.444 mV |
|Settling time (2%) @ 0.5V|t\_settle\_98 | Spec | 0.000 us | 1.000 us | 5.000 us |
| | | ('Sch',)|0.056 us | 0.070 us | 7.376 us |
