analogicus/lelo_gr04_sky130a/sim/LELO_GR04_BG/results/tran_Sch_mc.md

### Summary tran_Sch_mc

For details see <a href='tran_Sch_mc.html'>tran_Sch_mc.html</a>

|**Name**|**Parameter**|**View**|**Min** | **Typ** | **Max**|
|:---|:---|:---:|:---:|:---:|:---:|
|Active current|idd | Spec | 5.000 uA | 15.000 uA | 50.000 uA |
| | | ('Sch',)|13.315 uA | 15.972 uA | 18.713 uA |
|Leakage current|iddq | Spec | 0.000 nA | 0.500 nA | 1.000 nA |
| | | ('Sch',)|2.011 nA | 2.034 nA | 2.059 nA |
|Output current @ 0.2-1.1V|i0 | Spec | 1.000 uA | 1.700 uA | 2.600 uA |
| | | ('Sch',)|1.646 uA | 2.243 uA | 2.894 uA |
|Output current @ 0.2-1.1V|i1 | Spec | 1.000 uA | 1.700 uA | 2.600 uA |
| | | ('Sch',)|1.702 uA | 2.268 uA | 2.929 uA |
|Output current @ 0.2-1.1V|i2 | Spec | 1.000 uA | 1.700 uA | 2.600 uA |
| | | ('Sch',)|1.792 uA | 2.330 uA | 2.948 uA |
|Output current @ 0.2-1.1V|i3 | Spec | 1.000 uA | 1.700 uA | 2.600 uA |
| | | ('Sch',)|1.686 uA | 2.234 uA | 2.927 uA |
|Bandgap resistor voltage|vrd | Spec | 30.000 mV | 52.000 mV | 80.000 mV |
| | | ('Sch',)|45.365 mV | 56.100 mV | 65.723 mV |
|Settling time (2%) @ 0.5V|t\_settle\_98 | Spec | 0.000 us | 1.000 us | 5.000 us |
| | | ('Sch',)|0.075 us | 0.078 us | 0.081 us |
