analogicus/lelo_gr04_sky130a/sim/LELO_GR04_BG/results/lstb_Lay_etc.md

### Summary lstb_Lay_etc

For details see <a href='lstb_Lay_etc.html'>lstb_Lay_etc.html</a>

|**Name**|**Parameter**|**View**|**Min** | **Typ** | **Max**|
|:---|:---|:---:|:---:|:---:|:---:|
|Gain margin|gm\_db | Spec | -50.000 dB | -20.000 dB | -10.000 dB |
| | | ('Lay',)|-29.831 dB | -18.302 dB | -17.763 dB |
|Phase margin|pm\_deg | Spec | 45.000 deg | 60.000 deg | 90.000 deg |
| | | ('Lay',)|68.218 deg | 82.619 deg | 87.829 deg |
|Loop gain|lf\_gain | Spec | 20.000 dB | 35.000 dB | 50.000 dB |
| | | ('Lay',)|28.453 dB | 32.664 dB | 35.008 dB |
|Unity-gain frequency|f\_ug | Spec | 5.000 MHz | 15.000 MHz | 60.000 MHz |
| | | ('Lay',)|0.043 MHz | 8.062 MHz | 24.922 MHz |
