analogicus/lelo_gr04_sky130a/sim/LELO_GR04_BG/results/lstb_Lay_mc.md

### Summary lstb_Lay_mc

For details see <a href='lstb_Lay_mc.html'>lstb_Lay_mc.html</a>

|**Name**|**Parameter**|**View**|**Min** | **Typ** | **Max**|
|:---|:---|:---:|:---:|:---:|:---:|
|Gain margin|gm\_db | Spec | -50.000 dB | -20.000 dB | -10.000 dB |
| | | ('Lay',)|-18.389 dB | -18.318 dB | -18.266 dB |
|Phase margin|pm\_deg | Spec | 45.000 deg | 60.000 deg | 90.000 deg |
| | | ('Lay',)|79.370 deg | 83.388 deg | 88.024 deg |
|Loop gain|lf\_gain | Spec | 20.000 dB | 35.000 dB | 50.000 dB |
| | | ('Lay',)|32.225 dB | 33.675 dB | 34.463 dB |
|Unity-gain frequency|f\_ug | Spec | 5.000 MHz | 15.000 MHz | 60.000 MHz |
| | | ('Lay',)|6.202 MHz | 7.436 MHz | 8.208 MHz |
