analogicus/lelo_gr04_sky130a/sim/LELO_GR04_BG/results/lstb_Lay_typical.md

### Summary lstb_Lay_typical

For details see <a href='lstb_Lay_typical.html'>lstb_Lay_typical.html</a>

|**Name**|**Parameter**|**View**|**Min** | **Typ** | **Max**|
|:---|:---|:---:|:---:|:---:|:---:|
|Gain margin|gm\_db | Spec | -50.000 dB | -20.000 dB | -10.000 dB |
| | | ('Lay',)|-18.325 dB | -18.325 dB | -18.325 dB |
|Phase margin|pm\_deg | Spec | 45.000 deg | 60.000 deg | 90.000 deg |
| | | ('Lay',)|83.319 deg | 83.319 deg | 83.319 deg |
|Loop gain|lf\_gain | Spec | 20.000 dB | 35.000 dB | 50.000 dB |
| | | ('Lay',)|33.698 dB | 33.698 dB | 33.698 dB |
|Unity-gain frequency|f\_ug | Spec | 5.000 MHz | 15.000 MHz | 60.000 MHz |
| | | ('Lay',)|7.513 MHz | 7.513 MHz | 7.513 MHz |
