analogicus/lelo_gr04_sky130a/sim/LELO_GR04_BG/results/lstb_Sch_etc.md

### Summary lstb_Sch_etc

For details see <a href='lstb_Sch_etc.html'>lstb_Sch_etc.html</a>

|**Name**|**Parameter**|**View**|**Min** | **Typ** | **Max**|
|:---|:---|:---:|:---:|:---:|:---:|
|Gain margin|gm\_db | Spec | -50.000 dB | -20.000 dB | -10.000 dB |
| | | ('Sch',)|-32.718 dB | -18.900 dB | -17.499 dB |
|Phase margin|pm\_deg | Spec | 45.000 deg | 60.000 deg | 90.000 deg |
| | | ('Sch',)|62.961 deg | 84.667 deg | 89.233 deg |
|Loop gain|lf\_gain | Spec | 20.000 dB | 35.000 dB | 50.000 dB |
| | | ('Sch',)|28.833 dB | 32.636 dB | 35.187 dB |
|Unity-gain frequency|f\_ug | Spec | 5.000 MHz | 15.000 MHz | 60.000 MHz |
| | | ('Sch',)|0.051 MHz | 10.247 MHz | 30.220 MHz |
