analogicus/lelo_gr04_sky130a/sim/LELO_GR04_BG/results/lstb_Sch_mc.md

### Summary lstb_Sch_mc

For details see <a href='lstb_Sch_mc.html'>lstb_Sch_mc.html</a>

|**Name**|**Parameter**|**View**|**Min** | **Typ** | **Max**|
|:---|:---|:---:|:---:|:---:|:---:|
|Gain margin|gm\_db | Spec | -50.000 dB | -20.000 dB | -10.000 dB |
| | | ('Sch',)|-19.087 dB | -18.957 dB | -18.798 dB |
|Phase margin|pm\_deg | Spec | 45.000 deg | 60.000 deg | 90.000 deg |
| | | ('Sch',)|83.976 deg | 86.784 deg | 92.557 deg |
|Loop gain|lf\_gain | Spec | 20.000 dB | 35.000 dB | 50.000 dB |
| | | ('Sch',)|32.592 dB | 33.901 dB | 34.560 dB |
|Unity-gain frequency|f\_ug | Spec | 5.000 MHz | 15.000 MHz | 60.000 MHz |
| | | ('Sch',)|8.315 MHz | 9.337 MHz | 10.009 MHz |
