analogicus/lelo_gr04_sky130a/sim/LELO_GR04_BG/results/lstb_Sch_typical.md

### Summary lstb_Sch_typical

For details see <a href='lstb_Sch_typical.html'>lstb_Sch_typical.html</a>

|**Name**|**Parameter**|**View**|**Min** | **Typ** | **Max**|
|:---|:---|:---:|:---:|:---:|:---:|
|Gain margin|gm\_db | Spec | -50.000 dB | -20.000 dB | -10.000 dB |
| | | ('Sch',)|-18.961 dB | -18.961 dB | -18.961 dB |
|Phase margin|pm\_deg | Spec | 45.000 deg | 60.000 deg | 90.000 deg |
| | | ('Sch',)|86.682 deg | 86.682 deg | 86.682 deg |
|Loop gain|lf\_gain | Spec | 20.000 dB | 35.000 dB | 50.000 dB |
| | | ('Sch',)|33.867 dB | 33.867 dB | 33.867 dB |
|Unity-gain frequency|f\_ug | Spec | 5.000 MHz | 15.000 MHz | 60.000 MHz |
| | | ('Sch',)|9.240 MHz | 9.240 MHz | 9.240 MHz |
