analogicus/lelo_gr04_sky130a/sim/LELO_GR04/results/tran_Lay_etc_notemp.csv

 | idd_-45 | idd_25 | idd_125 | iddq_-45 | iddq_25 | iddq_125 | fosc_-45 | fosc_25 | fosc_125 | t_err_max | t_err_min | t_err_com_max | t_err_com_min | name | type | time | OK
0 | 16.96824 | 27.48329 | 42.82291 | 2.8077430000000003 | 11.256620000000002 | 44.93984 | 1.4796925637758016 | 2.179333432317362 | 3.564316534358971 | 1.651923123922316 | -4.636524480303379 | 1.651923123922316 | 0.02668018437023978 | tran_LayGtKfsTtVh | Lay | Tue Apr 28 20:36:25 2026 | False
1 | 15.684449999999998 | 25.187199999999997 | 39.55439 | 2.46963 | 2.834425 | 14.41366 | 1.4944585445005203 | 2.2027941587803337 | 3.5993322181817495 | 1.8483279674926933 | -4.596460368704257 | 1.8483279674926933 | 0.3998656361102837 | tran_LayGtKsfTtVh | Lay | Tue Apr 28 20:36:25 2026 | True
2 | 19.55438 | 31.435520000000004 | 49.01437 | 2.6431199999999997 | 8.862064 | 27.00429 | 1.942858457897658 | 2.8520751617925724 | 4.647900015537178 | 1.6365568498780796 | -4.016314270561139 | 1.6365568498780796 | 0.16685045511077012 | tran_LayGtKffTtVh | Lay | Tue Apr 28 20:36:24 2026 | True
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
