analogicus/lelo_gr04_sky130a/sim/LELO_GR04/results/tran_Lay_mc.csv

 | idd_-45 | idd_25 | idd_125 | iddq_-45 | iddq_25 | iddq_125 | fosc_-45 | fosc_25 | fosc_125 | t_err_max | t_err_min | t_err_com_max | t_err_com_min | name | type | time | OK
0 | 14.815840000000001 | 23.15127 | 37.42176 | 2.769444 | 3.443973 | 14.96144 | 1.40821068273553 | 2.0504102575711203 | 3.412164559618418 | 1.5253284383347605 | -4.025883604280963 | 1.5253284383347605 | -2.272599543592393 | tran_LayGtKttmmTtVt_29 | Lay | Tue Apr 28 20:36:39 2026 | False
1 | 9.427024000000001 | 18.66042 | 33.1022 | 2.7170929999999998 | 3.089373 | 15.414259999999999 | 0.9548905554203823 | 1.6409219217438487 | 2.918600918856872 | 11.512602187284898 | -35.395355417137836 | 8.329074973746444 | -9.639740152642302 | tran_LayGtKttmmTtVt_28 | Lay | Tue Apr 28 20:36:39 2026 | False
2 | 11.67537 | 21.167810000000003 | 36.10098 | 2.206611 | 3.4267830000000004 | 15.412980000000001 | 1.195120544689725 | 1.9056283357316863 | 3.2115293188057668 | 3.3103008926448894 | -21.367771210643212 | 3.099450837587741 | -5.627764681400983 | tran_LayGtKttmmTtVt_27 | Lay | Tue Apr 28 20:36:39 2026 | False
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
