analogicus/lelo_gr04_sky130a/sim/LELO_GR04/results/tran_Sch_etc_notemp.csv

 | idd_-45 | idd_25 | idd_125 | iddq_-45 | iddq_25 | iddq_125 | fosc_-45 | fosc_25 | fosc_125 | t_err_max | t_err_min | t_err_com_max | t_err_com_min | name | type | time | OK
0 | 16.7121 | 26.93612 | 41.632479999999994 | 1.3952440000000002 | 8.685205 | 39.50784 | 1.8197955564870074 | 2.718684728331927 | 4.673628395186784 | 3.6085915509461586 | -3.3760102727010093 | 1.9016792015555666 | 0.4273240039459334 | tran_SchGtKfsTtVh | Sch | Tue Apr 28 20:41:02 2026 | True
1 | 15.531250000000002 | 24.77674 | 38.61869 | 1.071341 | 1.691779 | 9.813219 | 1.838742259068255 | 2.727600023961344 | 4.559715576540167 | 1.6800437454182706 | -2.147671017847827 | 1.6800437454182706 | 0.7228116906622231 | tran_SchGtKsfTtVh | Sch | Tue Apr 28 20:41:01 2026 | True
2 | 19.17046 | 30.71571 | 47.5406 | 0.8554601 | 6.966713 | 21.82207 | 2.447885584689601 | 3.6436650642159667 | 6.185903075715566 | 1.8965294611151542 | -2.562831866728331 | 1.8965294611151542 | 0.6642697318087767 | tran_SchGtKffTtVh | Sch | Tue Apr 28 20:41:01 2026 | False
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
