analogicus/lelo_gr04_sky130a/sim/LELO_GR04/results/tran_Sch_mc.csv

 | idd_-45 | idd_25 | idd_125 | iddq_-45 | iddq_25 | iddq_125 | fosc_-45 | fosc_25 | fosc_125 | t_err_max | t_err_min | t_err_com_max | t_err_com_min | name | type | time | OK
0 | 14.96313 | 22.205920000000003 | 35.825770000000006 | 1.056068 | 1.9179469999999998 | 10.46196 | 1.9007534751565545 | 2.6085785642685617 | 4.333787558123916 | 10.449681605362237 | -4.24792754183612 | 1.4099769890945302 | -1.1188603976161215 | tran_SchGtKttmmTtVt_29 | Sch | Tue Apr 28 20:41:15 2026 | False
1 | 15.842149999999998 | 24.580109999999998 | 37.75758 | 1.170795 | 1.708934 | 10.543109999999999 | 2.0034372150633617 | 2.976376691373892 | 4.777318989316062 | 1.1498975493317616 | -10.559753996558086 | 0.718685968332351 | -4.134251735266916 | tran_SchGtKttmmTtVt_28 | Sch | Tue Apr 28 20:41:15 2026 | False
2 | 12.33887 | 22.22013 | 36.71477 | 1.322902 | 2.0091539999999997 | 10.36042 | 1.511410240326819 | 2.4886026311890426 | 4.277746429555047 | 2.460513626981964 | -22.374104397313303 | 2.1996966895115477 | -4.43126420730318 | tran_SchGtKttmmTtVt_27 | Sch | Tue Apr 28 20:41:15 2026 | False
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
