analogicus/lelo_gr04_sky130a/sim/LELO_GR04/results/tran_Sch_typical.csv

 | idd_-45 | idd_25 | idd_125 | iddq_-45 | iddq_25 | iddq_125 | fosc_-45 | fosc_25 | fosc_125 | t_err_max | t_err_min | t_err_com_max | t_err_com_min | name | type | time | OK
0 | 14.55008 | 23.08328 | 36.946419999999996 | 1.314144 | 1.913039 | 10.34914 | 1.8131554454209184 | 2.6959824823947325 | 4.521779430709656 | 0.13524532839198145 | -4.167275379577333 | 0.13524532839198145 | -1.063402603103527 | tran_SchGtKttTtVt | Sch | Tue Apr 28 20:40:54 2026 | True
