analogicus/lelo_gr04_sky130a/sim/LELO_GR04_OSC/results/tran_Sch_typical.html

| idd_-45 | idd_125 | iddq_-45 | iddq_125 | fosc_-45 | fosc_25 | fosc_125 | t_err_max | t_err_min
count | 1.000 uA | 1.000 uA | 1.000 nA | 1.000 nA | 1.000 MHz | 1.000 MHz | 1.000 MHz | 1.00 C | 1.00 C
mean | 11.206 uA | 32.826 uA | 0.653 nA | 111.091 nA | 1.153 MHz | 1.776 MHz | 3.092 MHz | 0.01 C | -3.03 C
std | nan uA | nan uA | nan nA | nan nA | nan MHz | nan MHz | nan MHz | nan C | nan C
min | 11.206 uA | 32.826 uA | 0.653 nA | 111.091 nA | 1.153 MHz | 1.776 MHz | 3.092 MHz | 0.01 C | -3.03 C
25% | 11.206 uA | 32.826 uA | 0.653 nA | 111.091 nA | 1.153 MHz | 1.776 MHz | 3.092 MHz | 0.01 C | -3.03 C
50% | 11.206 uA | 32.826 uA | 0.653 nA | 111.091 nA | 1.153 MHz | 1.776 MHz | 3.092 MHz | 0.01 C | -3.03 C
75% | 11.206 uA | 32.826 uA | 0.653 nA | 111.091 nA | 1.153 MHz | 1.776 MHz | 3.092 MHz | 0.01 C | -3.03 C
max | 11.206 uA | 32.826 uA | 0.653 nA | 111.091 nA | 1.153 MHz | 1.776 MHz | 3.092 MHz | 0.01 C | -3.03 C

idd_-45 | idd_125 | iddq_-45 | iddq_125 | fosc_-45 | fosc_25 | fosc_125 | t_err_max | t_err_min | name | type | time | OK
11.206 uA | 32.826 uA | 0.653 nA | 111.091 nA | 1.153 MHz | 1.776 MHz | 3.092 MHz | 0.01 C | -3.03 C | tran_SchGtKttTtVt | Sch | Sat Mar 21 20:20:29 2026 | False
