analogicus/lelo_gr04_sky130a/sim/LELO_GR04/results/output_tran/tran_LayGtKffTtVl_count.png

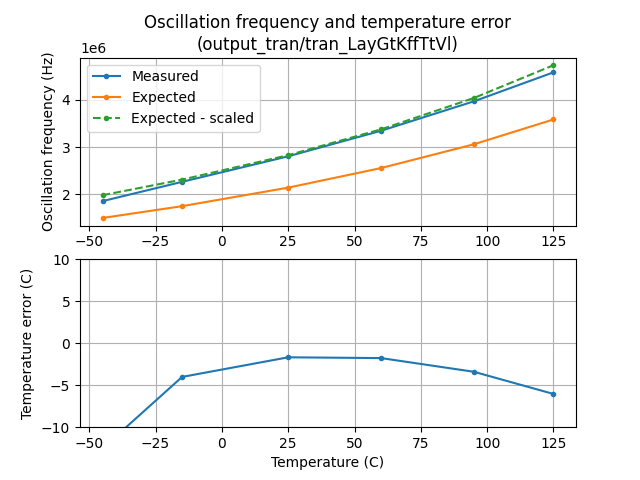
sim/LELO_GR04/results/output_tran/tran_LayGtKffTtVl_count.png
