analogicus/lelo_gr04_sky130a/sim/LELO_GR04/results/output_tran/tran_LayGtKttmmTtVt_2_count.png

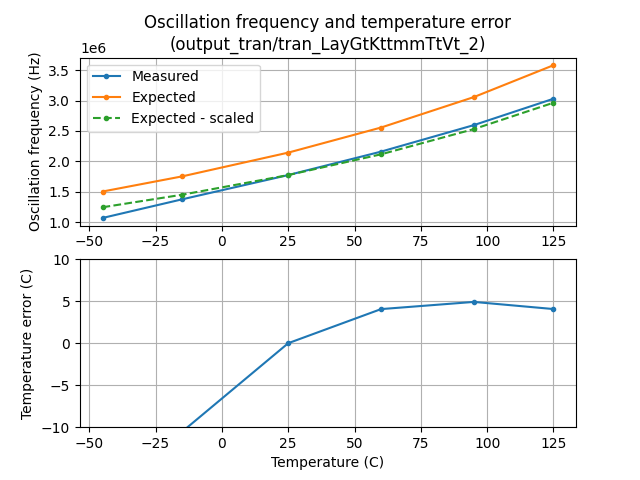
sim/LELO_GR04/results/output_tran/tran_LayGtKttmmTtVt_2_count.png
