analogicus/lelo_gr04_sky130a/sim/LELO_GR04/results/output_tran/tran_SchGtKffTtVh_count.png

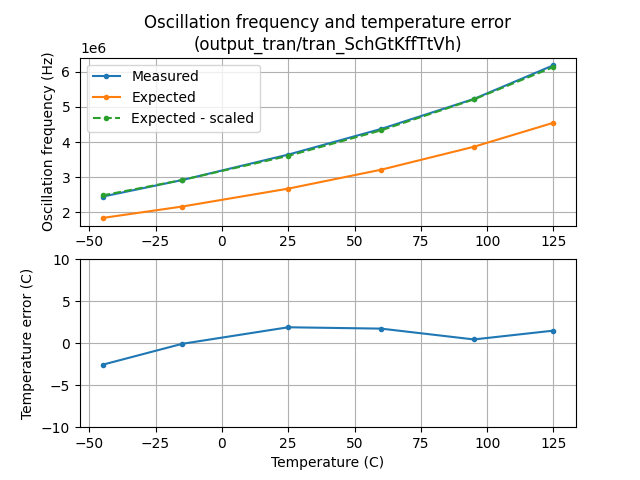
sim/LELO_GR04/results/output_tran/tran_SchGtKffTtVh_count.png
