analogicus/lelo_gr04_sky130a/rtl/osc_measure.pnl.v

module osc_measure (clk,
    osc_clk,
    pwrupOsc,
    rst_n,
    start,
    VPWR,
    VGND,
    count_value);
 input clk;
 input osc_clk;
 output pwrupOsc;
 input rst_n;
 input start;
 inout VPWR;
 inout VGND;
 output [7:0] count_value;

 wire _00_;
 wire _01_;
 wire _02_;
 wire _03_;
 wire _04_;
 wire _05_;
 wire _06_;
 wire _07_;
 wire _08_;
 wire _09_;
 wire _10_;
 wire _11_;
 wire _12_;
 wire _13_;
 wire _14_;
 wire _15_;
 wire _16_;
 wire _17_;
 wire _18_;
 wire _19_;
 wire _20_;
 wire _21_;
 wire _22_;
 wire _23_;
 wire _24_;
 wire _25_;
 wire _26_;
 wire _27_;
 wire _28_;
 wire _29_;
 wire _30_;
 wire _31_;
 wire _32_;
 wire _33_;
 wire _34_;
 wire _35_;
 wire _36_;
 wire _37_;
 wire \osc_counter[0] ;
 wire \osc_counter[1] ;
 wire \osc_counter[2] ;
 wire \osc_counter[3] ;
 wire \osc_counter[4] ;
 wire \osc_counter[5] ;
 wire \osc_counter[6] ;
 wire \osc_counter[7] ;
 wire \osc_counter[8] ;
 wire \state[0] ;
 wire \state[1] ;
 wire \state[2] ;
 wire \state[3] ;
 wire net1;
 wire net2;
 wire net3;
 wire net4;
 wire net5;
 wire net6;
 wire net7;
 wire net8;
 wire net9;
 wire net10;
 wire net11;
 wire net12;
 wire net13;
 wire net14;
 wire net15;
 wire clknet_0_clk;
 wire clknet_1_0__leaf_clk;
 wire clknet_1_1__leaf_clk;
 wire net16;
 wire net17;
 wire net18;
 wire net19;
 wire net20;
 wire net21;
 wire net22;
 wire net23;
 wire net24;
 wire net25;
 wire net26;

 sky130_fd_sc_hd__inv_2 _38_ (.A(net3),
    .VGND(VGND),
    .VNB(VGND),
    .VPB(VPWR),
    .VPWR(VPWR),
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
    .VNB(VGND),
    .VPB(VPWR),
    .VPWR(VPWR));
 sky130_fd_sc_hd__fill_2 FILLER_24_46 (.VGND(VGND),
    .VNB(VGND),
    .VPB(VPWR),
    .VPWR(VPWR));
 sky130_fd_sc_hd__fill_1 FILLER_24_61 (.VGND(VGND),
    .VNB(VGND),
    .VPB(VPWR),
    .VPWR(VPWR));
endmodule
