analogicus/lelo_gr04_sky130a/rtl/tb_osc_measure.v

`timescale 1ns/1ps

module tb_osc_measure;
    // Signals for our "virtual lab"
    reg clk = 0;
    reg osc_clk = 0;
    reg rst_n;
    reg start;
    wire pwrupOsc;
    wire [7:0] count_value;

    // Instantiate your module (Connect the wires)
    osc_measure uut (
        .clk(clk),
        .osc_clk(osc_clk),
        .start(start),
        .rst_n(rst_n),
        .pwrupOsc(pwrupOsc),
        .count_value(count_value)
    );

    // Generate Clocks
    always #15625 clk = ~clk; // ~32kHz clock
    always #50 osc_clk = ~osc_clk;   // Much faster "Oscillator" clock (10MHz)

    initial begin
        $dumpfile("simulation.vcd"); 
        $dumpvars(0, tb_osc_measure);

        // Stimulus (The test sequence)
        rst_n = 0; start = 0;
        #100000;
        rst_n = 1;
        #30000;
        start = 1;
        #30000;
        start = 0;
        #30000;
        start = 1;
        #30000;
        start = 0;
        #30000;
        rst_n = 0;
        #20000;
        rst_n = 1;
        #60000;
        start = 1;
        #30000;
        start = 0;

        #1000000; // Wait for simulation to run
        $display("Simulation Finished. Open GTKWave to see results.");
        $finish;
    end
endmodule
