analogicus/lelo_gr04_sky130a/(commit log)

2026-01-04 Made LELO_GR04_SKY130A
    [LELO_GR04.sch]
2026-01-22 Added default sch and lay
    [LELO_GR04.sch, tt_um_lelo_gr04_analogicus.sch]
2026-02-07 PMOS-input OTA: optran works
    Optran sim works for BG circuit, less current in OTA than expected. No AC simulation yet
    [LELO_GR04_BG.sch, LELO_GR04_BG_BJT.sch, LELO_GR04_BG_OTA_PMOS.sch, TB_LELO_GR04_BG.sch, TB_LELO_GR04_BG_BJT.sch, TB_LELO_GR04_BG_OTA.sch]
2026-02-07 Bandgap: optran works, more rigorous OTA design
    [LELO_GR04_BG.sch, LELO_GR04_BG_OTA_PMOS.sch, TB_LELO_GR04_BG.sch, TB_LELO_GR04_BG_OTA.sch]
2026-02-08 Bandgap-OTA: optran works
    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
    [LELO_GR04_BG.sch, LELO_GR04_BG_BJT.sch, LELO_GR04_BG_OTA_PMOS.sch, TB_LELO_GR04_BG.sch, TB_LELO_GR04_BG_BJT.sch, TB_LELO_GR04_BG_OTA.sch]
2026-02-08 Bandgap: add PWRUP_N_1V8, LPI, LPO
    [LELO_GR04_BG.sch, LELO_GR04_BG_OTA_PMOS.sch, TB_LELO_GR04_BG.sch, TB_LELO_GR04_BG_OTA.sch]
2026-02-08 Bandgap-OTA: open loop f_ug=5MHz cph_ug=-120deg
    [LELO_GR04_BG_OTA_PMOS.sch, TB_LELO_GR04_BG_OTA.sch]
2026-02-08 Bandgap: add PWRUP(_N) circuit
    Working, but not yet able to reset LPI (VP)
    [LELO_GR04_BG.sch, LELO_GR04_BG_OTA_PMOS.sch, TB_LELO_GR04_BG.sch]
2026-02-09 Bandgap: prototype to pullup VP (not working yet)
    [LELO_GR04_BG.sch, TB_LELO_GR04_BG.sch]
2026-02-09 Bandgap: add transient simulation
    [tran_Sch_etc.csv, tran_Sch_mc.csv, tran_Sch_typical.csv]
2026-02-09 Bandgap: tran: add PTAT resistor voltage
    [tran_Sch_etc.csv, tran_Sch_mc.csv, tran_Sch_typical.csv]
2026-02-09 Bandgap: add loop stability sim
    Gain margin = 7dB, phase margin = 25deg. One corner unity-gain freq is 0.2MHz -> could cascoding help with varying Vds?
    [lstb_Sch_etc.csv, lstb_Sch_mc.csv, lstb_Sch_typical.csv]
2026-02-09 Bandgap: X1->X4 compensation pm=59deg gm=-16dB
    Can use lead compensation too, with area cost
    [LELO_GR04_BG.sch, lstb_Sch_etc.csv, lstb_Sch_mc.csv, lstb_Sch_typical.csv]
2026-02-09 Bandgap: add LPI pullup according to Razavi's (coupling from PWRUP)
    Transient quite short but seems enough. Introduced leakage
    [LELO_GR04_BG.sch]
2026-02-10 Bandgap: add PTAT current output + dc sweep
    Cascode generation according to Carsten and Perrott
    [LELO_GR04_BG.sch, LELO_GR04_BG_OUTPUT.sch, TB_LELO_GR04_BG.sch, dc_Sch_etc.csv, dc_Sch_mc.csv, dc_Sch_typical.csv, lstb_Sch_mc.csv, lstb_Sch_typical.csv]
2026-02-10 Bandgap: use regulated cascode instead, PMOS outputs
    [LELO_GR04_BG.sch, LELO_GR04_BG_OTA_PMOS.sch, LELO_GR04_BG_OUTPUT.sch, TB_LELO_GR04_BG.sch, dc_Sch_etc.csv, dc_Sch_mc.csv, dc_Sch_typical.csv, lstb_Sch_etc.csv]
2026-02-10 Bandgap: tran: add output currents & settling time (2%)
    [tran_Sch_etc.csv, tran_Sch_mc.csv, tran_Sch_typical.csv]
2026-02-13 Bandgap: add VCTAT measurements
    [dc_Sch_etc.csv, dc_Sch_mc.csv, dc_Sch_typical.csv]
2026-02-27 Bandgap: improve PM, leakage current (when correctly measured)
    [LELO_GR04_BG.sch, dc_Sch_etc.csv, dc_Sch_mc.csv, dc_Sch_typical.csv, lstb_Sch_etc.csv, lstb_Sch_mc.csv, lstb_Sch_typical.csv, tran_Sch_etc.csv]
2026-02-27 Bandgap: use wider/lower leakage transistors
    [LELO_GR04_BG.sch, LELO_GR04_BG_OTA_PMOS.sch, LELO_GR04_BG_OUTPUT.sch, dc_Sch_etc.csv, dc_Sch_mc.csv, dc_Sch_typical.csv, lstb_Sch_etc.csv, lstb_Sch_mc.csv]
2026-02-27 Bandgap: fix DC testbench error at low temperatures
    [dc_Sch_etc.csv, dc_Sch_mc.csv, dc_Sch_typical.csv]
2026-02-27 Bandgap: fix TRAN testbench oscillations (?)
    [tran_Sch_etc.csv, tran_Sch_mc.csv, tran_Sch_typical.csv]
2026-02-27 Bandgap-OTA: increase tail resistor -> less compensation
    [LELO_GR04_BG.sch, LELO_GR04_BG_OTA_PMOS.sch, dc_Sch_etc.csv, dc_Sch_mc.csv, dc_Sch_typical.csv, lstb_Sch_etc.csv, lstb_Sch_mc.csv, lstb_Sch_typical.csv]
2026-02-28 Bandgap: re-add compensation, create VX port
    Without compensation it does not work at low temperatures (likely due to strange phases)
    [LELO_GR04_BG.sch, TB_LELO_GR04_BG.sch, dc_Sch_etc.csv, dc_Sch_mc.csv, dc_Sch_typical.csv, lstb_Sch_etc.csv, lstb_Sch_mc.csv, lstb_Sch_typical.csv]
2026-03-02 Oscillator & Comparator schematics and symbols
    [LELO_GR04_COMP.sch, LELO_GR04_OSC.sch]
2026-03-02 update with the Test Bench
    [LELO_GR04_OSC.sch, TB_OSCILLATOR.sch]
2026-03-03 Updated TB
    [TB_OSCILLATOR.sch]
2026-03-05 Osc: duplicate to v2
    [LELO_GR04_OSC_v2.sch]
2026-03-05 OSC: create working oscillator
    [LELO_GR04_COMP.sch, LELO_GR04_OSC_v2.sch, TB_LELO_GR04_COMP.sch, TB_LELO_GR04_OSC.sch]
2026-03-05 Oscillator: improve design
    [LELO_GR04_OSC_v2.sch]
2026-03-05 Oscillator: add simulation testbench & results
    [tran_Sch_etc.csv, tran_Sch_mc.csv, tran_Sch_typical.csv]
2026-03-06 Updated Comparator
    [LELO_GR04_COMP.sch]
2026-03-06 Oscillator-COMP: fix flipped nmos, parallel inverters
    [LELO_GR04_COMP.sch, LELO_GR04_OSC_v2.sch]
2026-03-06 Oscillator: add TRAN testbenches and results
    [tran_Sch_etc.csv, tran_Sch_etc_notemp.csv, tran_Sch_mc.csv, tran_Sch_typical.csv]
2026-03-06 Oscillator: add documentation
    [tran_Sch_etc_notemp.csv, tran_Sch_typical.csv]
2026-03-07 Oscillator: add calibration & error
2026-03-10 Oscillator: measure frequency instead of count
    [tran_Sch_etc_notemp.csv, tran_Sch_typical.csv]
2026-03-10 Oscillator: add lower-leakage inverter & mc test results
    [LELO_GR04_INV.sch, LELO_GR04_OSC_v2.sch, TB_LELO_GR04_INV.sch, tran_Sch_etc_notemp.csv, tran_Sch_mc.csv, tran_Sch_typical.csv]
2026-03-13 rtl verilog script
    [LELO_GR04_OSC.sch, TB_OSCILLATOR.sch]
2026-03-19 Updaded Oscillator With D FlipFlop
    [LELO_GR04_OSC.sch, TB_OSCILLATOR.sch]
2026-03-19 Bandgap: remove cap in output
    [LELO_GR04_BG_OUTPUT.sch, dc_Sch_etc.csv, dc_Sch_mc.csv, dc_Sch_typical.csv, lstb_Sch_etc.csv, lstb_Sch_mc.csv, lstb_Sch_typical.csv, tran_Sch_etc.csv]
2026-03-19 Oscillator: add curve-fit for typical, calibration for etc at Vt
    Numbers from Bandgap testbench do not model well the actual frequency curves
    [calibration_typical.yaml, tran_Sch_etc_notemp.csv, tran_Sch_mc.csv, tran_Sch_typical.csv]
2026-03-19 Oscillator: add testbenches for oscillator v1
    [calibration_typical.yaml, tran_Sch_typical.csv]
2026-03-19 Oscillator: fix tran.py rising edge count
    [calibration_typical.yaml, tran_Sch_etc_notemp.csv, tran_Sch_mc.csv, tran_Sch_typical.csv]
2026-03-20 Temp: add top-level component & testbench
    [LELO_GR04.sch, TB_LELO_GR04.sch]
2026-03-20 Layout-BG: create layout for OTA
    [LELO_GR04_BG_OTA_PMOS.sch]
2026-03-20 Layout-bandgap: completed OTA layout
    [LELO_GR04_BG.sch, LELO_GR04_BG_OTA_PMOS.sch, LELO_GR04_BG_OUTPUT.sch]
2026-03-20 Layout-bandgap: add output block layout
    [LELO_GR04_BG_OUTPUT.sch]
2026-03-21 Layout-bandgap: initial layout for bandgap
    [LELO_GR04_BG.sch]
2026-03-21 Layout-bandgap: reduce complexity of output, change gating for bandgap
    [LELO_GR04_BG.sch, LELO_GR04_BG_OUTPUT.sch, calibration_typical.yaml, dc_Sch_etc.csv, dc_Sch_mc.csv, dc_Sch_typical.csv, lstb_Sch_etc.csv, lstb_Sch_mc.csv]
2026-03-21 Layout-bandgap: completed layout for bandgap
    [LELO_GR04.sch, LELO_GR04_BG.sch, calibration_typical.yaml, dc_Sch_etc.csv, dc_Sch_mc.csv, dc_Sch_typical.csv, lstb_Sch_etc.csv, lstb_Sch_mc.csv]
2026-03-21 Layout-bandgap: add parasitic extraction simulation
    [dc_Lay_etc.csv, dc_Lay_mc.csv, dc_Lay_typical.csv, lstb_Lay_etc.csv, lstb_Lay_mc.csv, lstb_Lay_typical.csv, tran_Lay_etc.csv, tran_Lay_mc.csv]
2026-03-21 Layout-osc: add layout for inverter
    [LELO_GR04_INV.sch]
2026-03-21 Layout-osc: add layout for comparator
    [LELO_GR04_COMP.sch]
2026-03-23 Layout-oscillator: add layout of oscillator
    [LELO_GR04_OSC_v2.sch]
2026-03-23 Layout-oscillator: add layout simulation results
    [calibration_typical.yaml, tran_Lay_etc_notemp.csv, tran_Lay_mc.csv, tran_Lay_typical.csv]
2026-03-23 Layout: fix schematic for TB_OSCILLATOR
    [TB_OSCILLATOR.sch]
2026-03-23 Layout: add schematic sim & layout for top-level design
    [LELO_GR04.sch, calibration_typical.yaml, tran_Sch_etc_notemp.csv, tran_Sch_mc.csv, tran_Sch_typical.csv]
2026-03-23 Layout: add layout simulation results
    [calibration_typical.yaml, tran_Lay_etc_notemp.csv, tran_Lay_mc.csv, tran_Lay_typical.csv]
2026-03-27 Digital: fix incorrect pwrupOsc timing, reduce width
    [osc_measure.v, tb_osc_measure.v]
2026-03-27 Layout: add analog + digital LVS
    [tt_um_lelo_gr04_analogicus.sch]
2026-03-28 TT: use rst_n, tie high uio_oe[7:0], pwrup to output instead of input
    [tt_um_lelo_gr04_analogicus.sch]
2026-04-01 Bandgap: change gate transistor, aligning sim with theory
    [LELO_GR04_BG.sch, calibration_typical.yaml, tran_Lay_etc_notemp.csv, tran_Lay_mc.csv, tran_Lay_typical.csv, tran_Sch_etc_notemp.csv, tran_Sch_mc.csv, tran_Sch_typical.csv]
2026-04-01 Temp: add 0-70C calibration error
    [tran_Lay_etc_notemp.csv, tran_Lay_mc.csv, tran_Lay_typical.csv, tran_Sch_etc_notemp.csv, tran_Sch_mc.csv, tran_Sch_typical.csv]
2026-04-01 Simulations: incorrect typical Sch
    [tran_Sch_typical.csv]
2026-04-17 Upgraded Oscillator
    [LELO_GR04_OSC.sch, TB_OSCILLATOR.sch]
2026-04-28 Temp: add measurements at 25C
    [tran_Lay_etc_notemp.csv, tran_Lay_mc.csv, tran_Lay_typical.csv, tran_Sch_etc_notemp.csv, tran_Sch_mc.csv, tran_Sch_typical.csv]
